originlabs/origin-opensource-faceshield/README.md

# origin-opensource-faceshield
Origin's open source DLP, SLA, and SLS printable ANSI compliant (ANSI Z87.1, 9.17.2) face shield design, for public use under MPL license. Instructions for use are found in EDOC-10019-000 IFU, FS-104, FACE SHIELD ASSEMBLY, ORIGIN.
