originlabs/origin-opensource-faceshield/DFaM for DLP or SLA printing/FS-104-00 FACE SHIELD VISOR, DLP BOTTOM UP OPTIMIZED, FOR STERILIZABLE MATERIALS, ORIGIN REV A.STL

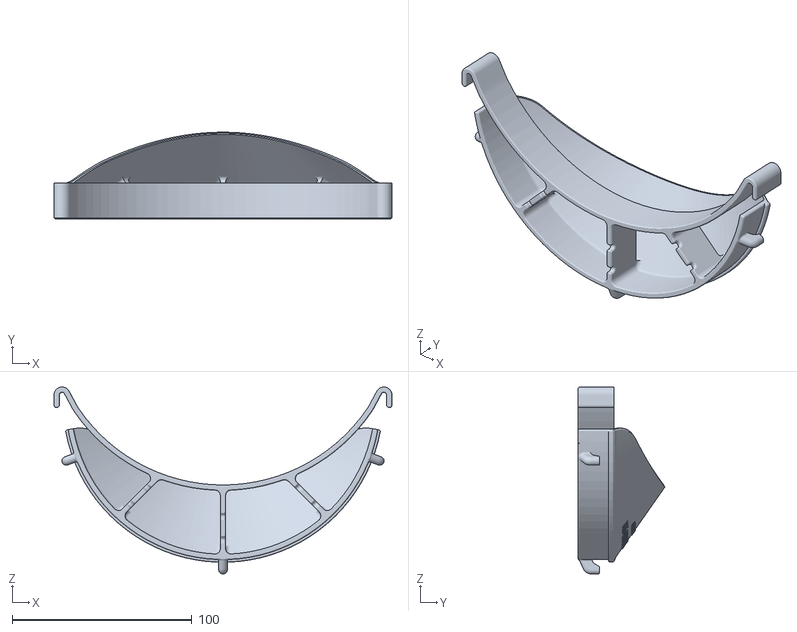
[picture p1: CAD file, 2020-04-15]
DFaM for DLP or SLA printing/FS-104-00 FACE SHIELD VISOR, DLP BOTTOM UP OPTIMIZED, FOR STERILIZABLE MATERIALS, ORIGIN REV A.STL
188.0 x 48.2 x 104.0
