originlabs/origin-opensource-faceshield/DFaM for SLS printing/FS-104-06 FACE SHIELD VISOR, SLS OPTIMIZED, FOR NON-STERILIZABLE MATERIALS, ORIGIN REV A.STL

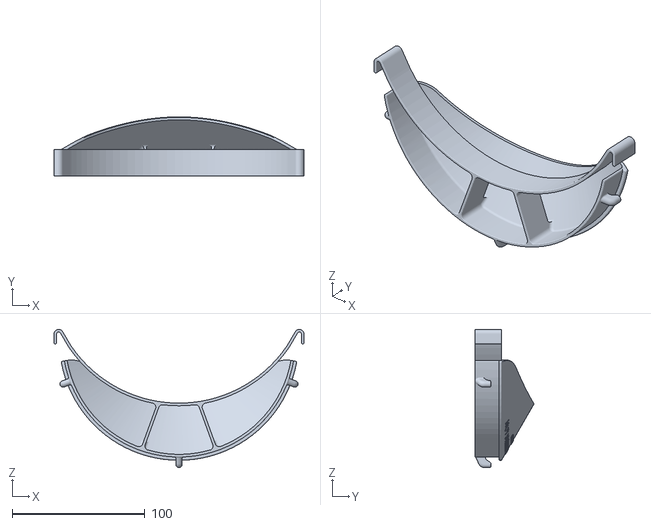
[picture p2: CAD file, 2020-04-15]
DFaM for SLS printing/FS-104-06 FACE SHIELD VISOR, SLS OPTIMIZED, FOR NON-STERILIZABLE MATERIALS, ORIGIN REV A.STL
188.0 x 44.5 x 104.0
