originlabs/origin-opensource-faceshield/FS-106 ELASTIC BAND, FACE SHIELD REV A.dxf

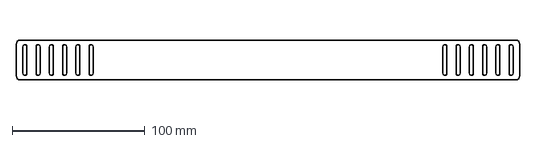
[picture p3: CAD file, 2020-04-13]
FS-106 ELASTIC BAND, FACE SHIELD REV A.dxf
380.0 x 30.0 mm
