originlabs/origin-opensource-faceshield/FS-105 FACE SHIELD, PLASTIC, 3 HOLE PUNCH, FOR FS-104, FLAT PATTERN REV A.DXF

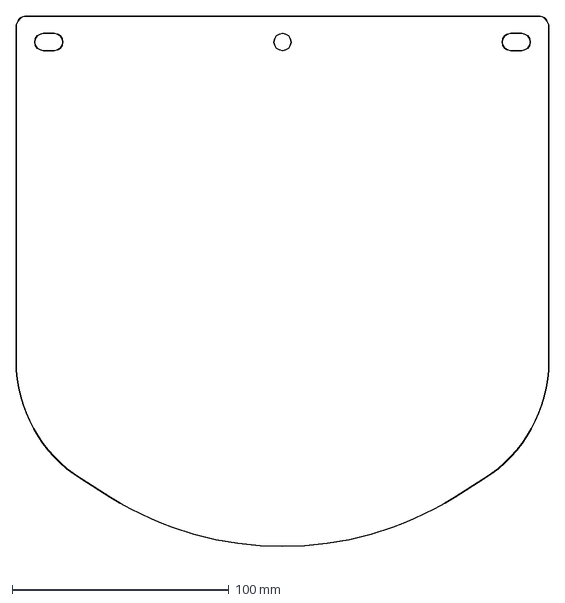
[picture p4: CAD file, 2020-04-13]
FS-105 FACE SHIELD, PLASTIC, 3 HOLE PUNCH, FOR FS-104, FLAT PATTERN REV A.DXF
246.0 x 252.6 mm
