originlabs/origin-opensource-faceshield/(list of files, cad)

Other CAD files:
DFaM for DLP or SLA printing/FS-104-07 FACE SHIELD VISOR, DLP BOTTOM UP OPTIMIZED, FOR NON-STERILIZABLE MATERIALS, ORIGIN REV A.STL
DFaM for SLS printing/FS-104-05 FACE SHIELD VISOR, SLS OPTIMIZED, FOR STERILIZABLE MATERIALS, ORIGIN REV A.STL
