originlabs/origin-opensource-faceshield/(commit log)

2020-04-09 Adding initial files
    [FS-104 FACEMASK, FLEXIBLE TOP SHIELD, ORIGIN ONE BUILD AREA REV 2.STL, FS-104-01 FACEMASK, FLEXIBLE TOP SHIELD, ORIGIN ONE BUILD AREA, TOP STACKABLE REV 3.STL, FS-104-02 FACEMASK, FLEXIBLE TOP SHIELD, ORIGIN ONE BUILD AREA, SLS OPTIMIZED REV 1.STL, FS-104-03 FACEMASK, FLEXIBLE TOP SHIELD, ORIGIN ONE BUILD AREA, SLS OPTIMIZED, 2MM WALL REV 1.STL, FS-104-04 FACEMASK, FLEXIBLE TOP SHIELD, ORIGIN ONE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]
2020-04-10 Updating to approved STLs
    [FS-104 FACEMASK, FLEXIBLE TOP SHIELD, ORIGIN ONE BUILD AREA REV 2.STL, FS-104-00 FACE SHIELD VISOR, TOP COVER, DLP OPTIMIZED, FOR STERILIZABLE MATERIALS, ORIGIN REV 2.STL, FS-104-01 FACE SHIELD VISOR, TOP COVER, DLP OPTIMIZED, FOR STERILIZABLE MATERIALS, TOP STACKABLE, ORIGIN, REV 2.STL, FS-104-01 FACEMASK, FLEXIBLE TOP SHIELD, ORIGIN ONE BUILD AREA, TOP STACKABLE REV 3.STL, FS-104-02 FACEMASK, F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]
2020-04-13 Updating part files to Rev A, removing top stackable SLA variant until better tested
    [FS-104-00 FACE SHIELD VISOR, TOP COVER, DLP OPTIMIZED, FOR STERILIZABLE MATERIALS, ORIGIN REV 2.STL, FS-104-00 FACE SHIELD VISOR, TOP COVER, DLP OPTIMIZED, FOR STERILIZABLE MATERIALS, ORIGIN REV A.STL, FS-104-01 FACE SHIELD VISOR, TOP COVER, DLP OPTIMIZED, FOR STERILIZABLE MATERIALS, TOP STACKABLE, ORIGIN, REV 2.STL, FS-104-05 FACE SHIELD VISOR, TOP COVER, SLS OPTIMIZED, FOR STERILIZABLE MATERIAL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]
2020-04-13 Adding IFU
    [FS-104-00 FACE SHIELD VISOR, DLP OPTIMIZED, FOR STERILIZABLE MATERIALS, ORIGIN REV A.STL, FS-104-05 FACE SHIELD VISOR, SLS OPTIMIZED, FOR STERILIZABLE MATERIALS, ORIGIN REV A.STL, FS-104-06 FACE SHIELD VISOR, SLS OPTIMIZED, FOR NON-STERILIZABLE MATERIALS, ORIGIN REV A.STL, FS-104-07 FACE SHIELD VISOR, DLP OPTIMIZED, FOR NON-STERILIZABLE MATERIALS, ORIGIN REV A.STL]
2020-04-15 Updating part names to make it clear that -00 and -07 variants are optimized for bottom-up style DLP / SLA printers
    [FS-104-00 FACE SHIELD VISOR, DLP BOTTOM UP OPTIMIZED, FOR STERILIZABLE MATERIALS, ORIGIN REV A.STL, FS-104-00 FACE SHIELD VISOR, DLP OPTIMIZED, FOR STERILIZABLE MATERIALS, ORIGIN REV A.STL, FS-104-05 FACE SHIELD VISOR, SLS OPTIMIZED, FOR STERILIZABLE MATERIALS, ORIGIN REV A.STL, FS-104-06 FACE SHIELD VISOR, SLS OPTIMIZED, FOR NON-STERILIZABLE MATERIALS, ORIGIN REV A.STL, FS-104-07 FACE SHIELD VIS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]
